Sorin1310/P1_oscilator_sinusoidal_audiofrecventa/README.md

# Oscilator de Audiofrecvență cu Semnal Sinusoidal

Acest proiect reprezintă documentația și proiectarea unui **oscilator de audiofrecvență** capabil să genereze semnale sinusoidale curate. Proiectul a fost realizat pentru disciplina *Circuite Electronice Fundamentale 2*.

## 🎯 Obiective și Cerințe
* **Funcționalitate:** Generarea unui semnal sinusoidal stabil în gama de audiofrecvență.
* **Cerințe tehnice:** * Tensiunea de alimentare: $V_{CC} = 13V$.
    * Amplitudinea semnalului de ieșire: $V_{out} \geq 0V$ (vârf la vârf).
    * Distorsiuni armonice reduse pentru o sinusoidă cât mai precisă.

---

## 🛠️ Componente și Tehnologii
Proiectul acoperă atât partea de calcul teoretic, cât și simularea și proiectarea fizică:
* **Analiză Teoretică:** Dimensionarea rețelelor de reacție (Wien, Dublu T sau Gamma).
* **Simulare:** Verificarea schemei electrice și a punctelor statice de funcționare (PSF).
* **Instrumente:** Utilizarea tehnicilor CAD pentru module electronice.

---

## 📂 Structura Proiectului
Documentația este organizată în capitole detaliate:
1. **Introducere și Descrierea temei:** Contextul utilizării oscilatoarelor în electronică.
2. **Rețele de reacție:** Analiza comparativă între puntea Wien, rețeaua Dublu T și rețeaua Gamma.
3. **Schema Electrică:** Implementarea montajului cu tranzistoare/amplificatoare operaționale.
4. **Simulări:** Rezultatele obținute în mediul de simulare pentru validarea frecvenței și amplitudinii.
5. **Realizarea Practică:** Proiectarea cablajului imprimat și lista de componente.

---

## 📊 Rezultate Tehnice
* **Stabilitatea Frecvenței:** Obținută prin utilizarea componentelor de precizie în rețeaua de reacție.
* **Regimul de funcționare:** Determinarea corectă a punctelor statice de funcționare (PSF) pentru a evita saturarea semnalului.

---

## 🚀 Cum se utilizează documentația
1. **Consultă Schema Electrică:** Identifică valorile componentelor din capitolul dedicat.
2. **Verifică Simulările:** Compară rezultatele tale cu graficele de semnal incluse în document.

---

## 👤 Autor
**Chirițoiu Constantin-Sorin** **Grupa: 433B** *Facultatea de Electronică, Telecomunicații și Tehnologia Informației* *Universitatea Națională de Știință și Tehnologie POLITEHNICA București*

---
**Coordonatori Științifici:**
* Prof. dr. ing. Dragoș Dobrescu
* Ș.l. dr. ing. Mădălin Moise
