Sorin1310/P1_oscilator_sinusoidal_audiofrecventa/Schema_bloc_oscilator .jpg

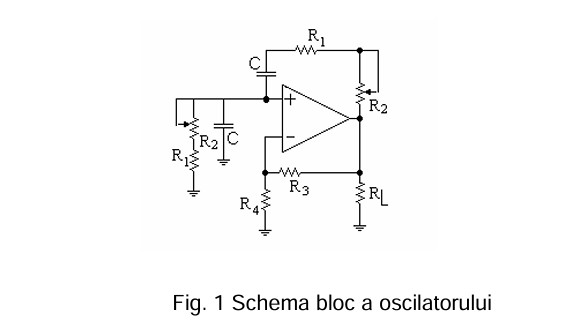
Schema_bloc_oscilator .jpg
