Sorin1310/P1_oscilator_sinusoidal_audiofrecventa/(list of files, drawings)

Other design files:
OSC_WIEN/DESIGN1.DSN
OSC_WIEN/Design1.opj
OSC_WIEN/OSC_WIEN.DSN
OSC_WIEN/OSC_WIEN.opj
