Sorin1310/P1_oscilator_sinusoidal_audiofrecventa/(commit log)

2026-03-03 Initial commit with LFS
    [DESIGN1.DSN, Design1.opj, OSC_WIEN.DSN, OSC_WIEN.opj]
2026-03-03 Update README to remove PCB design references
    Removed PCB design section from the README.
